vuquocviet0511/Project_02/Hình ảnh & video demo/HOME/PCB thực tế bottom chưa linh kiện.jpg

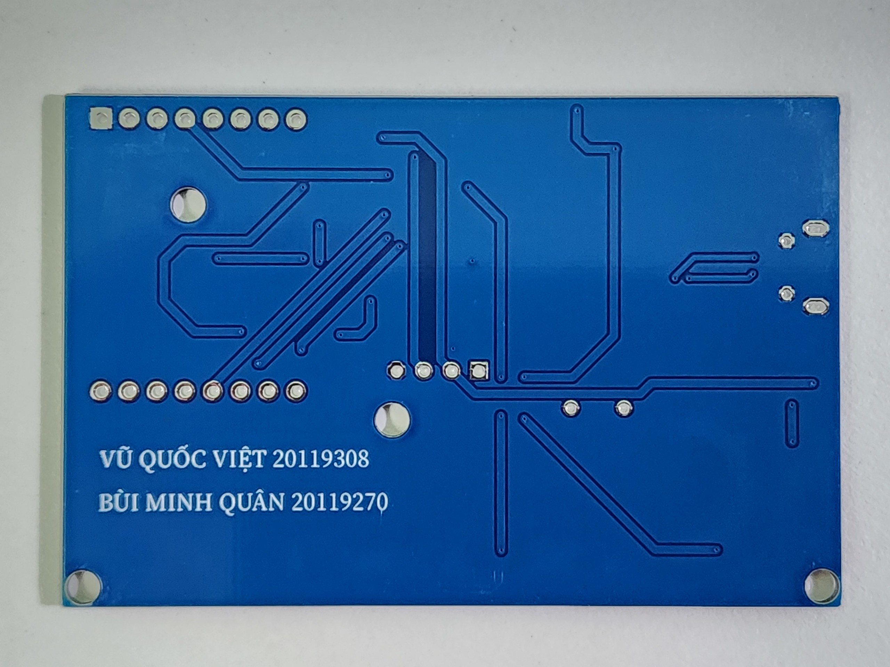
Hình ảnh & video demo/HOME/PCB thực tế bottom chưa linh kiện.jpg
