vuquocviet0511/Project_02/Tóm tắt nội dung các thư mục.docx

ĐỒ ÁN 2:

THIẾT KẾ THIẾT BỊ HỖ TRỢ CHĂM SÓC, GIÁM SÁT CÂY TRỒNG TỪ XA QUA LORA

Thông tin liên lạc:

- Họ và tên: Bùi Minh Quân - MSSV: 20119270 - SĐT: 0353070105 - Mail: 20119270@student.hcmute.edu.vn.
- Họ và tên: Vũ Quốc Việt - MSSV: 20119308 - SĐT: 0866453474 - Mail: 20119308@student.hcmute.edu.vn.

Thư mục đồ án 1 gồm có các mục sau:

- Thư mục “Báo cáo” chứa báo cáo của nhóm về đề tài.
- Thư mục “Hình ảnh và video demo sản phẩm”: Chứa video kiểm tra hoạt động của hệ thống, ảnh PCB trước khi và sau khi lắp linh kiện và ảnh 3D khi có linh kiện: Gồm 3 thư mục
- Thư mục FARM: Chứa 7 ảnh mạch (mặt trước và mặt sau trước và sau khi hàn, mặt trước và ảnh 3D khi gắn đầy đủ các linh kiện).
- Thư mục HOME: Chứa 7 ảnh mạch (mặt trước và mặt sau trước và sau khi hàn, mặt trước và ảnh 3D khi gắn đầy đủ các linh kiện).
- Thư mục Video demo: Gồm 1 video chạy hệ thống
- Thư mục “PCB ”: chứa các tệp tin vẽ PCB.
  - Gồm 2 thư mục của FARM và HOME.
- Thư mục “Schematic ”: chứa các tệp tin vẽ PCB.
  - Gồm 2 thư mục của FARM và HOME.
- Thư mục “Source code”
  - Gồm 3 thư mục code của FARM, HOME và code Web.
- Thư mục “Tài liệu từng module” chứa các tài liệu về module mà nhóm sử dụng.
