vuquocviet0511/Project_02/Tài liệu từng module/Tài liệu hướng dẫn nạp ESP8266 bằng CH340G.docx

Sinh viên thực hiện :

Vũ Quốc Việt 20119308

Bùi Minh Quân 20119270

TAI LIỆU NẠP CODE CHO CHIP ESP8266 BẰNG CH340G

1. Chuẩn bị linh kiện

Tên linh kiện | Số lượng
ESP8266(ESP-12E/12F) | 1
CH340G | 1
Cổng Micro USB | 1
IC Hạ áp LM1117-3V3 | 1
Thạch anh 12MHz | 1
BUTTON | 2
LED đơn | 5
Trở 10K | 5
Trở 1,5K | 3
Trở 470R | 3
Tụ 10u | 2
Tụ 22u | 1
Tụ 100n | 7
Tụ 22p | 2

2. Sơ đồ nguyên lý
- Để nạp code cho chip ESP-12E ta cần 3 khối bao gồm :
a) Khối xử lý (ESP-12E)

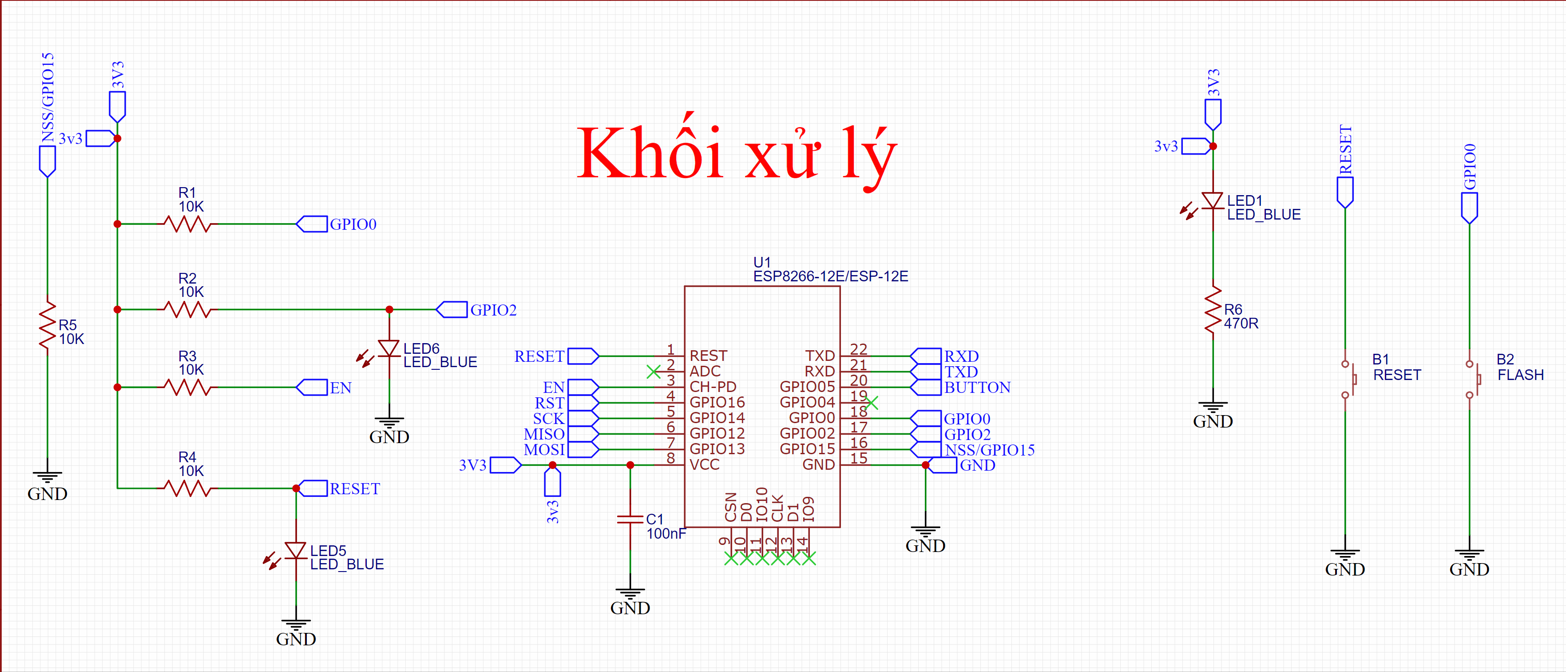
[picture p11: figure]

Hình 1: Khối xử lý

b) Khối nguồn 3V3 dùng để cấp nguồn cho CH340 và ESP-12E

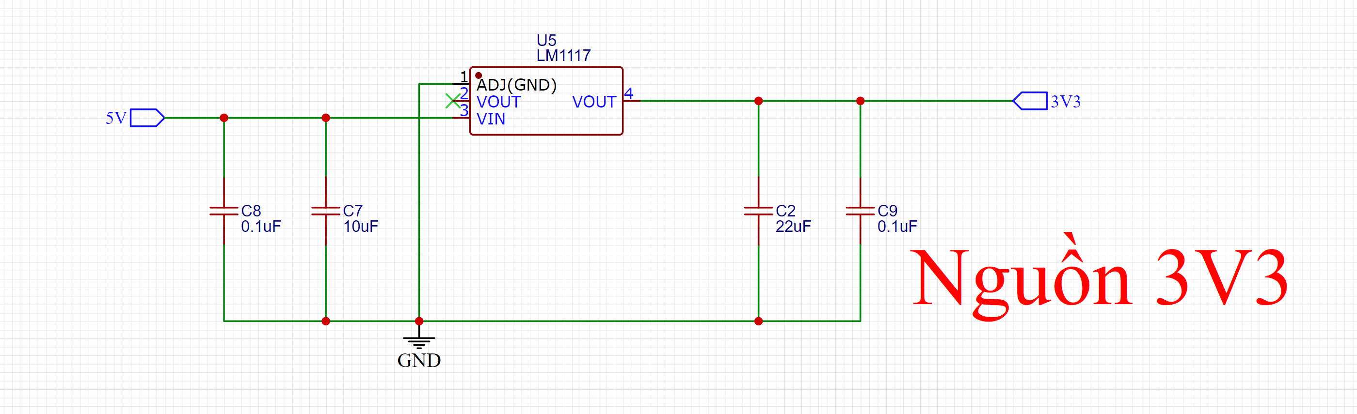
[picture p12: figure]

Hình 2: Khối nguồn 3V3

c) Khối nạp CH340G

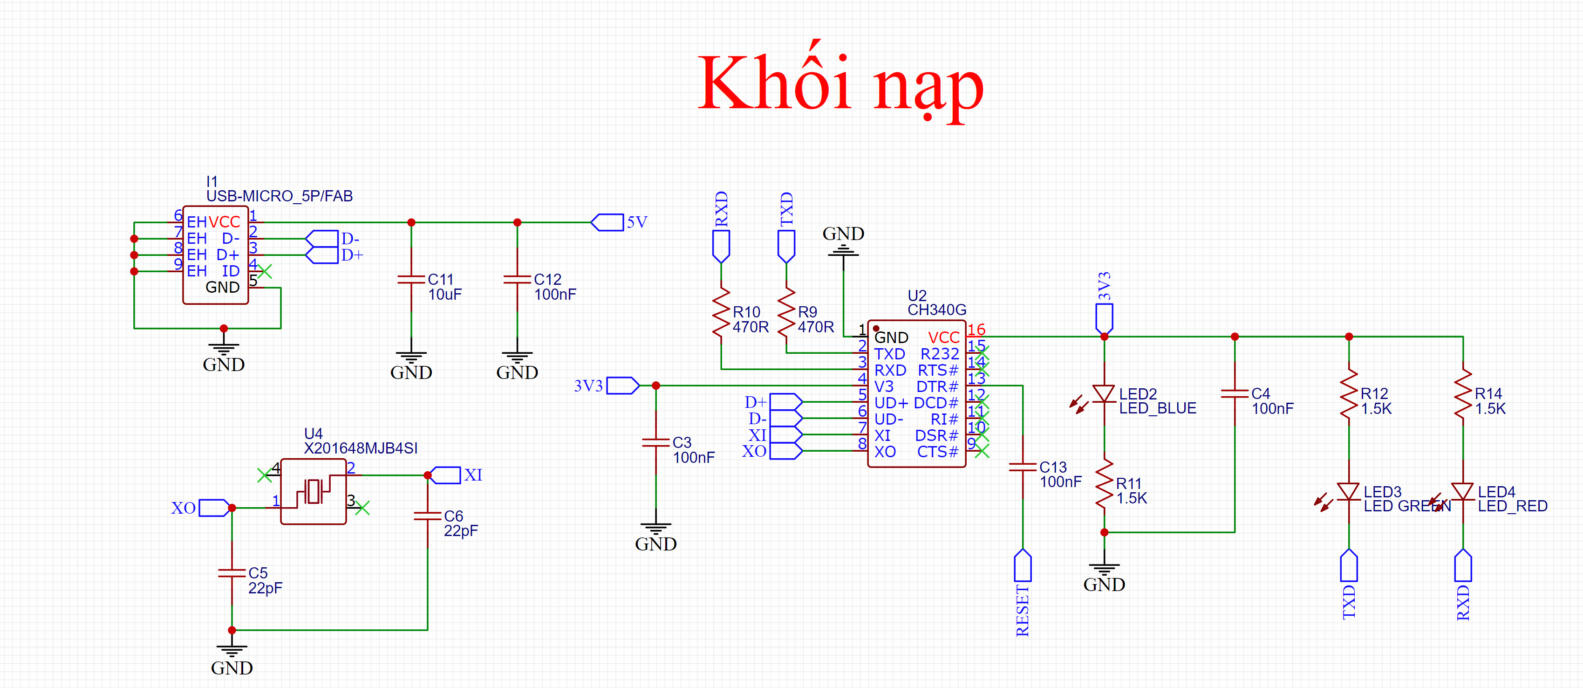
[picture p13: figure]

Hình 3: Khối nạp CH340G

3. Sơ đồ nối dây

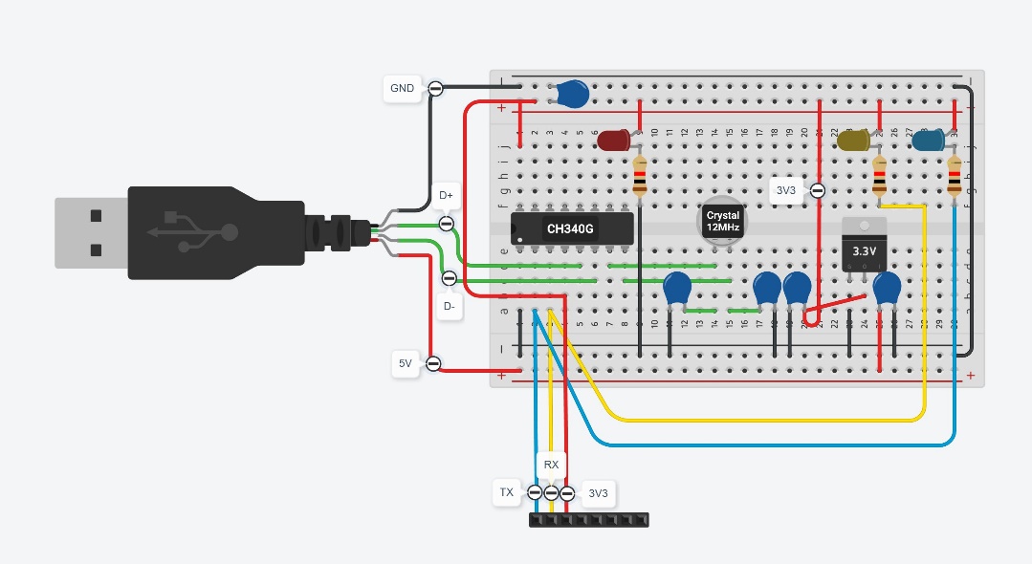
[picture p14: figure]

Hình 4: Sơ đồ nối dây mô phỏng

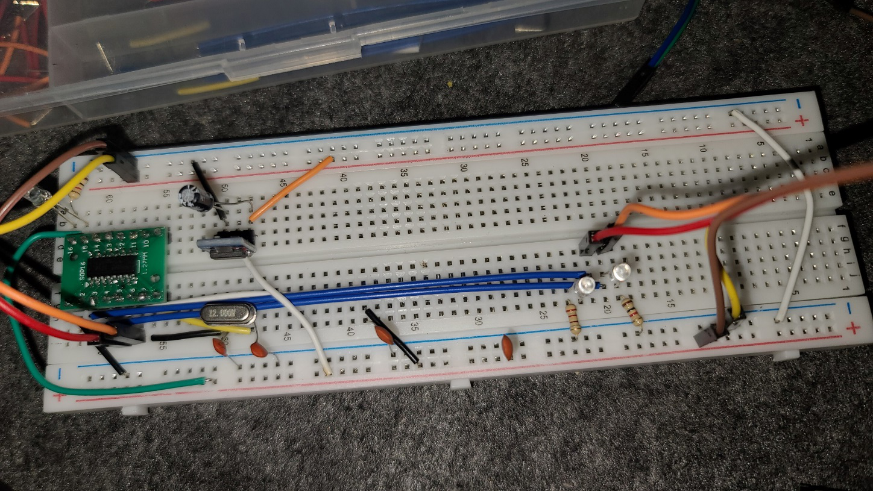
[picture p15: figure]

Hình 5: Sơ đồ nối dây thực tế

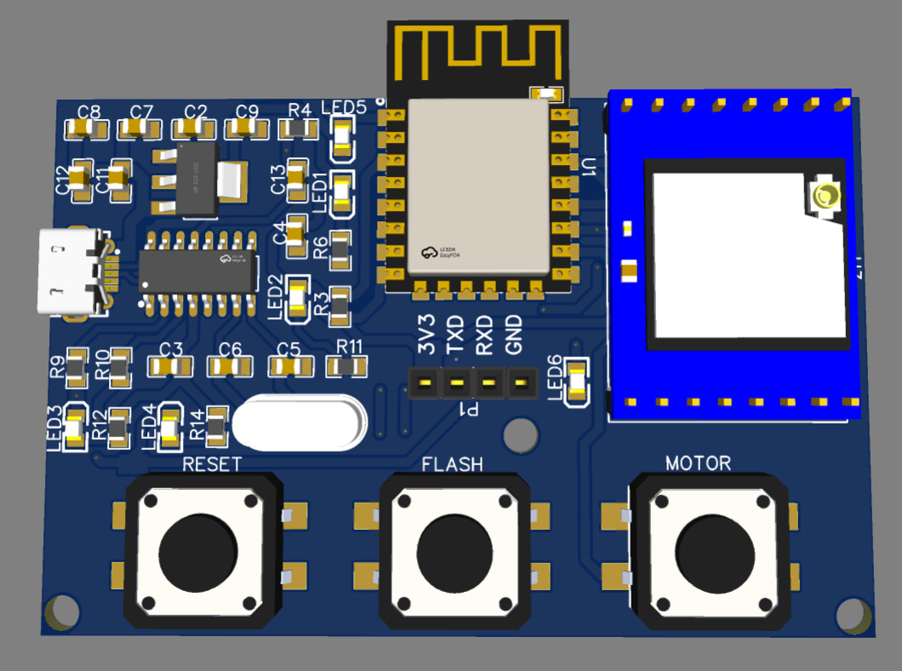
[picture p16: figure]

Hình 6: Khối nạp CH340G, ESP-12E, LM1117 được tích hợp vào PCB

4. Kết quả

Link : https://youtu.be/BsXcRCAsmZ0

- Trình tự các bước nạp: Cắm dây nạp → Mở Aruduino → Click → Đè FLASH đến khi hiện “Connecting______” → Kích RESET.
5. Lưu ý
- ESP 8266 cần thiết lập các mức logic sau để hoạt động

VCC | 3.3V
GND | GND
RST | HIGH
EN | HIGH

- ESP8266 có 2 chế độ : Run mode và Flash mode
- Run mode

GPIO 0 | HIGH
GPIO 2 | HIGH
GPIO 15 | LOW

- Flash mode

GPIO 0 | LOW
GPIO 2 | HIGH
GPIO 15 | LOW

- Do đó khi nạp code cho ESP8266 ta cần phải đè nút FLASH để giữ cho GPIO 0 xuống mức logic LOW để ESP8266 chuyển sang chế độ Flash mode và nạp code
- Link tham khảo : https://www.youtube.com/watch?v=fdV708CTMlw&t=135s
- Khi nạp đè nút Flash cho đến khi hiện Connecting___ thì kích nút Reset code sẽ được nhận
- CH340G có thể hoạt động ở 2 mức điện áp 5V và 3V3.
- VCC=5V : Chân V3 của CH340G sẽ đc nối với tụ 0.01uF
- VCC=3V3 : Chân V3 của CH340G được nối lên VCC

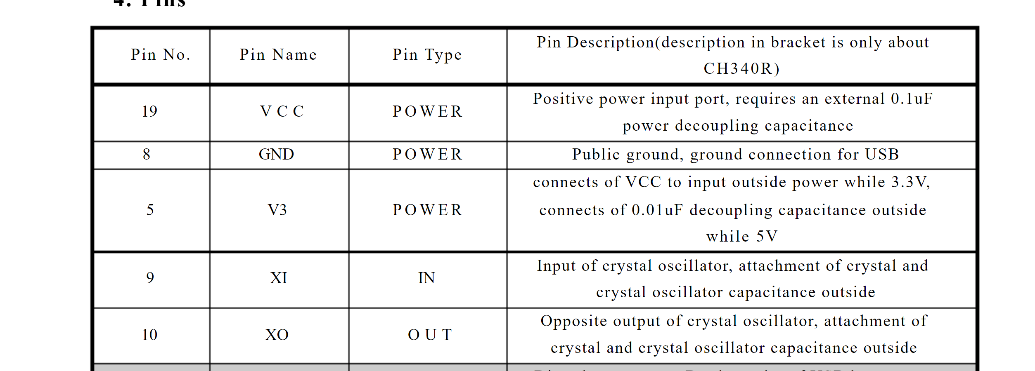
[picture p17: figure]
Không có mô tả.

Hình 7: Chức năng chân V3 CH340G (datasheet)

- Nên hàn thêm header nối các chân TX, RX ra bo để dự phòng trường hợp CH340G không nạp được ta vẫn có thể nạp bằng USB to TTL (module CH340G)

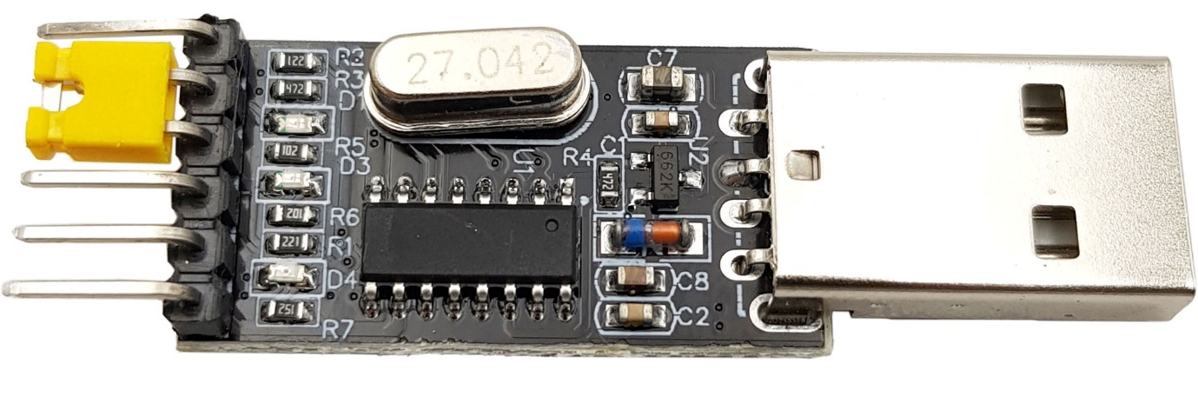
[picture p18: figure]
Usb to ttl ch340g

Hình 8: Hình ảnh thực tế USB to TTL CH340G
