vuquocviet0511/Project_02/Hình ảnh & video demo/HOME/Bản vẽ PCB EDA.jpg

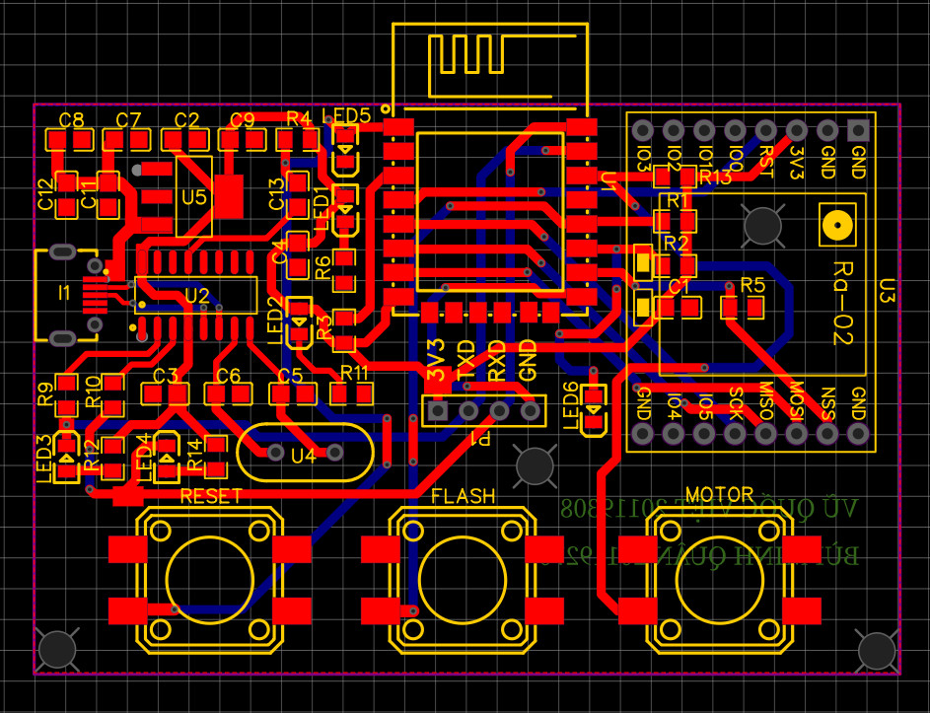
Hình ảnh & video demo/HOME/Bản vẽ PCB EDA.jpg
