vuquocviet0511/Project_02/Hình ảnh & video demo/HOME/Hình 3D PCB mặt top chưa linh kiện.jpg

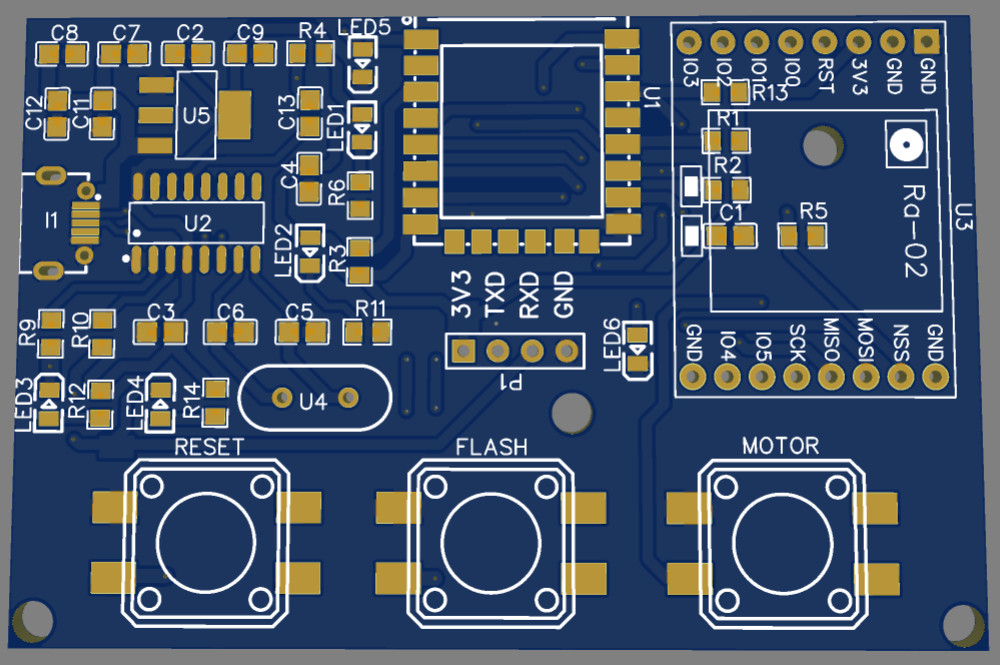
Hình ảnh & video demo/HOME/Hình 3D PCB mặt top chưa linh kiện.jpg
