vuquocviet0511/Project_02/(list of files, drawings)

Other design files:
PCB/FARM/PCB_FARM_2023-08-20.json
PCB/HOME/PCB_HOME_2023-08-20.json
SCHEMATIC/FARM/SCH_FARM_2023-08-20.json
SCHEMATIC/HOME/SCH_HOME_2023-08-20.json
